bzzzm/commodity-hw/rev1/doc/images/jlcpcb/back.jpg

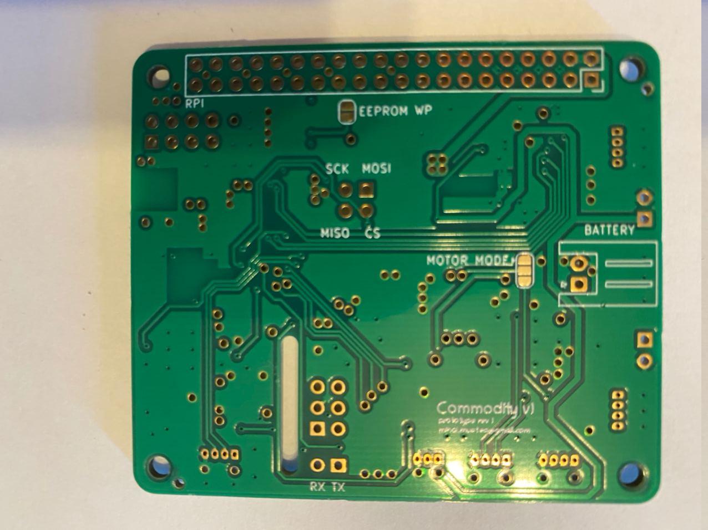
rev1/doc/images/jlcpcb/back.jpg
