bzzzm/commodity-hw/rev1/doc/images/render/top.png

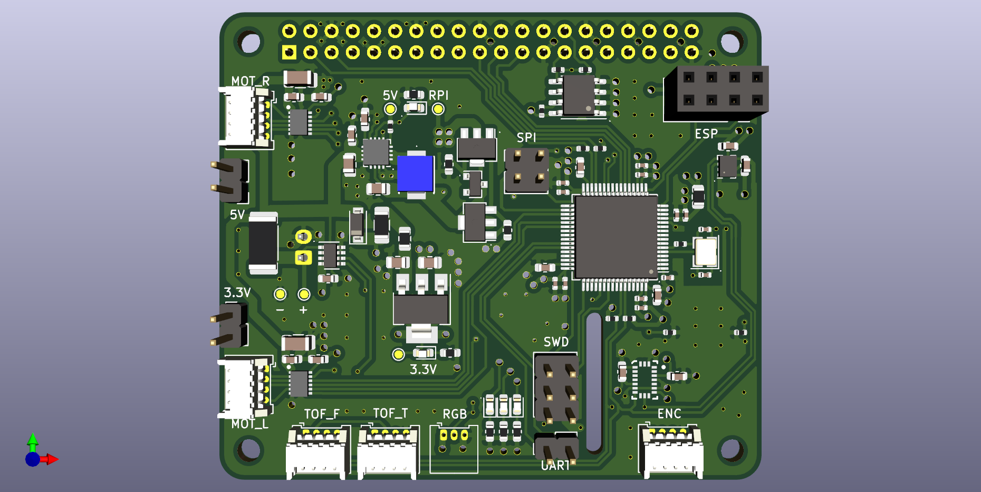
rev1/doc/images/render/top.png
