bzzzm/commodity-hw/README.md

# Commodity - Board

This project requires Kicad 5.1. It should include everything required to order
the board and assemble it (PCBA).
