bzzzm/commodity-hw/rev1/doc/datasheet/README.md

# Datasheet

If you are running linux, you can run `download.sh` to get all the PDFs you need for this board in case you need them offline. All `.pdf` files from `doc` directory are ignored using `gitignore`.
