bzzzm/commodity-hw/rev1/doc/Pins.md

## SWD

Pins are rotated on the board by 180, pin 1 has a square footprint.

  1. +3V3
  2. NRST
  3. GND
  4. SWO
  5. SWCLK
  6. SWDIO
  
## TOF

## MOT_L

## MOT_R

## RGB

## ESP01
