bzzzm/commodity-hw/rev1/doc/images/jlcpcb/front.jpg

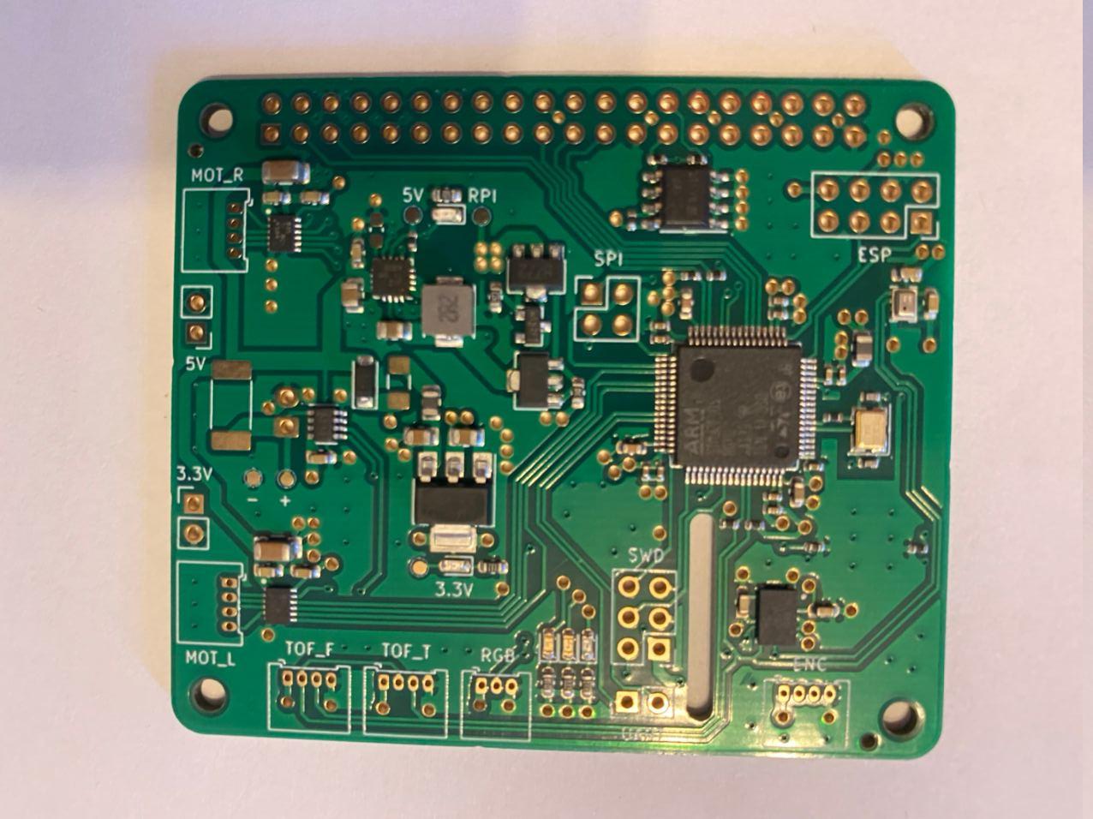
rev1/doc/images/jlcpcb/front.jpg
