bzzzm/commodity-hw/rev1/doc/images/jlcpcb/on_rpi.jpg

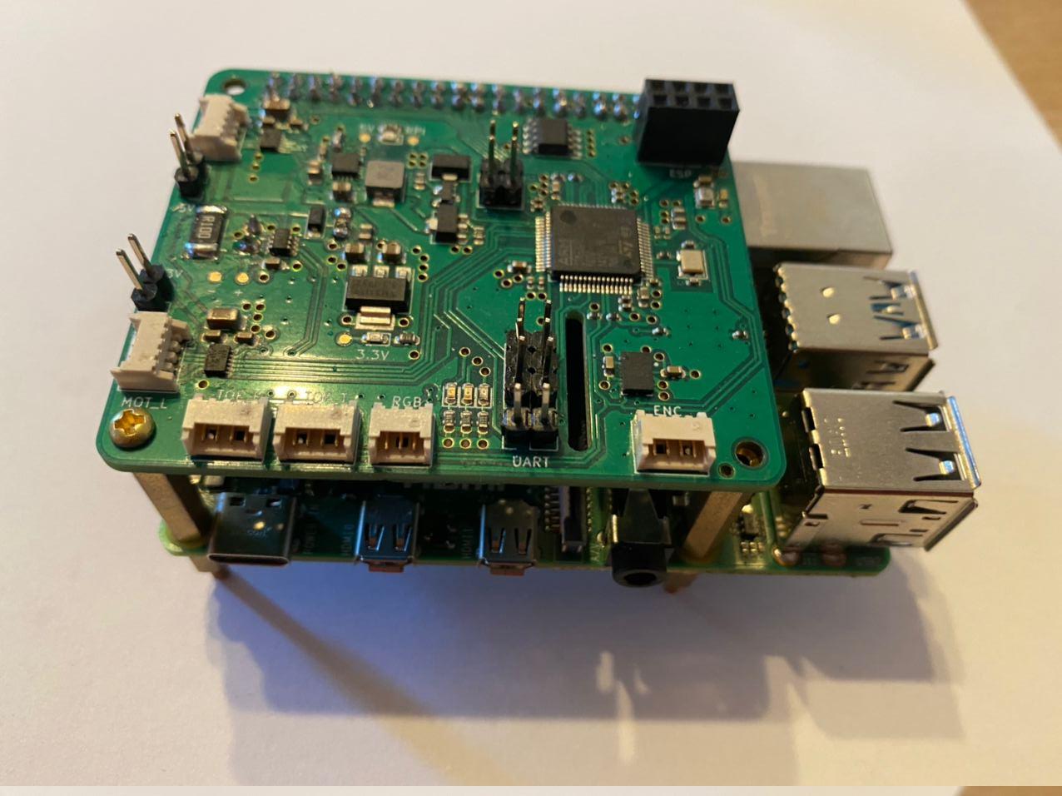
rev1/doc/images/jlcpcb/on_rpi.jpg
