bzzzm/commodity-hw/rev1/doc/images/render/3d-whatever.png

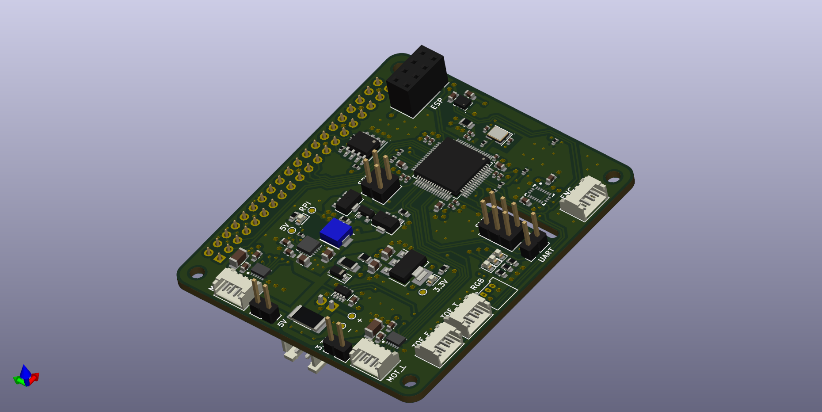
rev1/doc/images/render/3d-whatever.png
