bzzzm/commodity-hw/rev1/doc/images/render/back.png

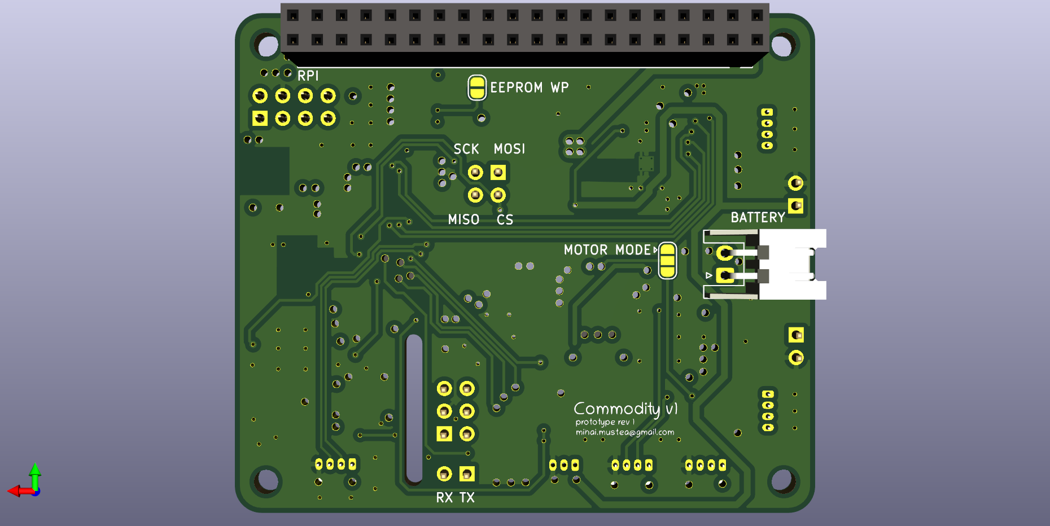
rev1/doc/images/render/back.png
