bzzzm/commodity-hw/rev1/asm/v1-Farnell-bom.csv

Part Number | Quantity | Description
2819768 | 1 | 620pf
2291894 | 1 | 800mA
2779802 | 1 | MOT_L
2779802 | 1 | MOT_R
1516289 | 1 | BAT
2779802 | 1 | ENC Header
9732918 | 1 | RGB Strip Header
2779802 | 1 | TOF_FRONT Header
2779802 | 1 | TOF1_TOP Header
1435952RL | 1 | 0.01
