bzzzm/commodity-hw/rev1/v1.kicad_pcb

## KiCad design rev1/v1.kicad_pcb (2020-09-15)

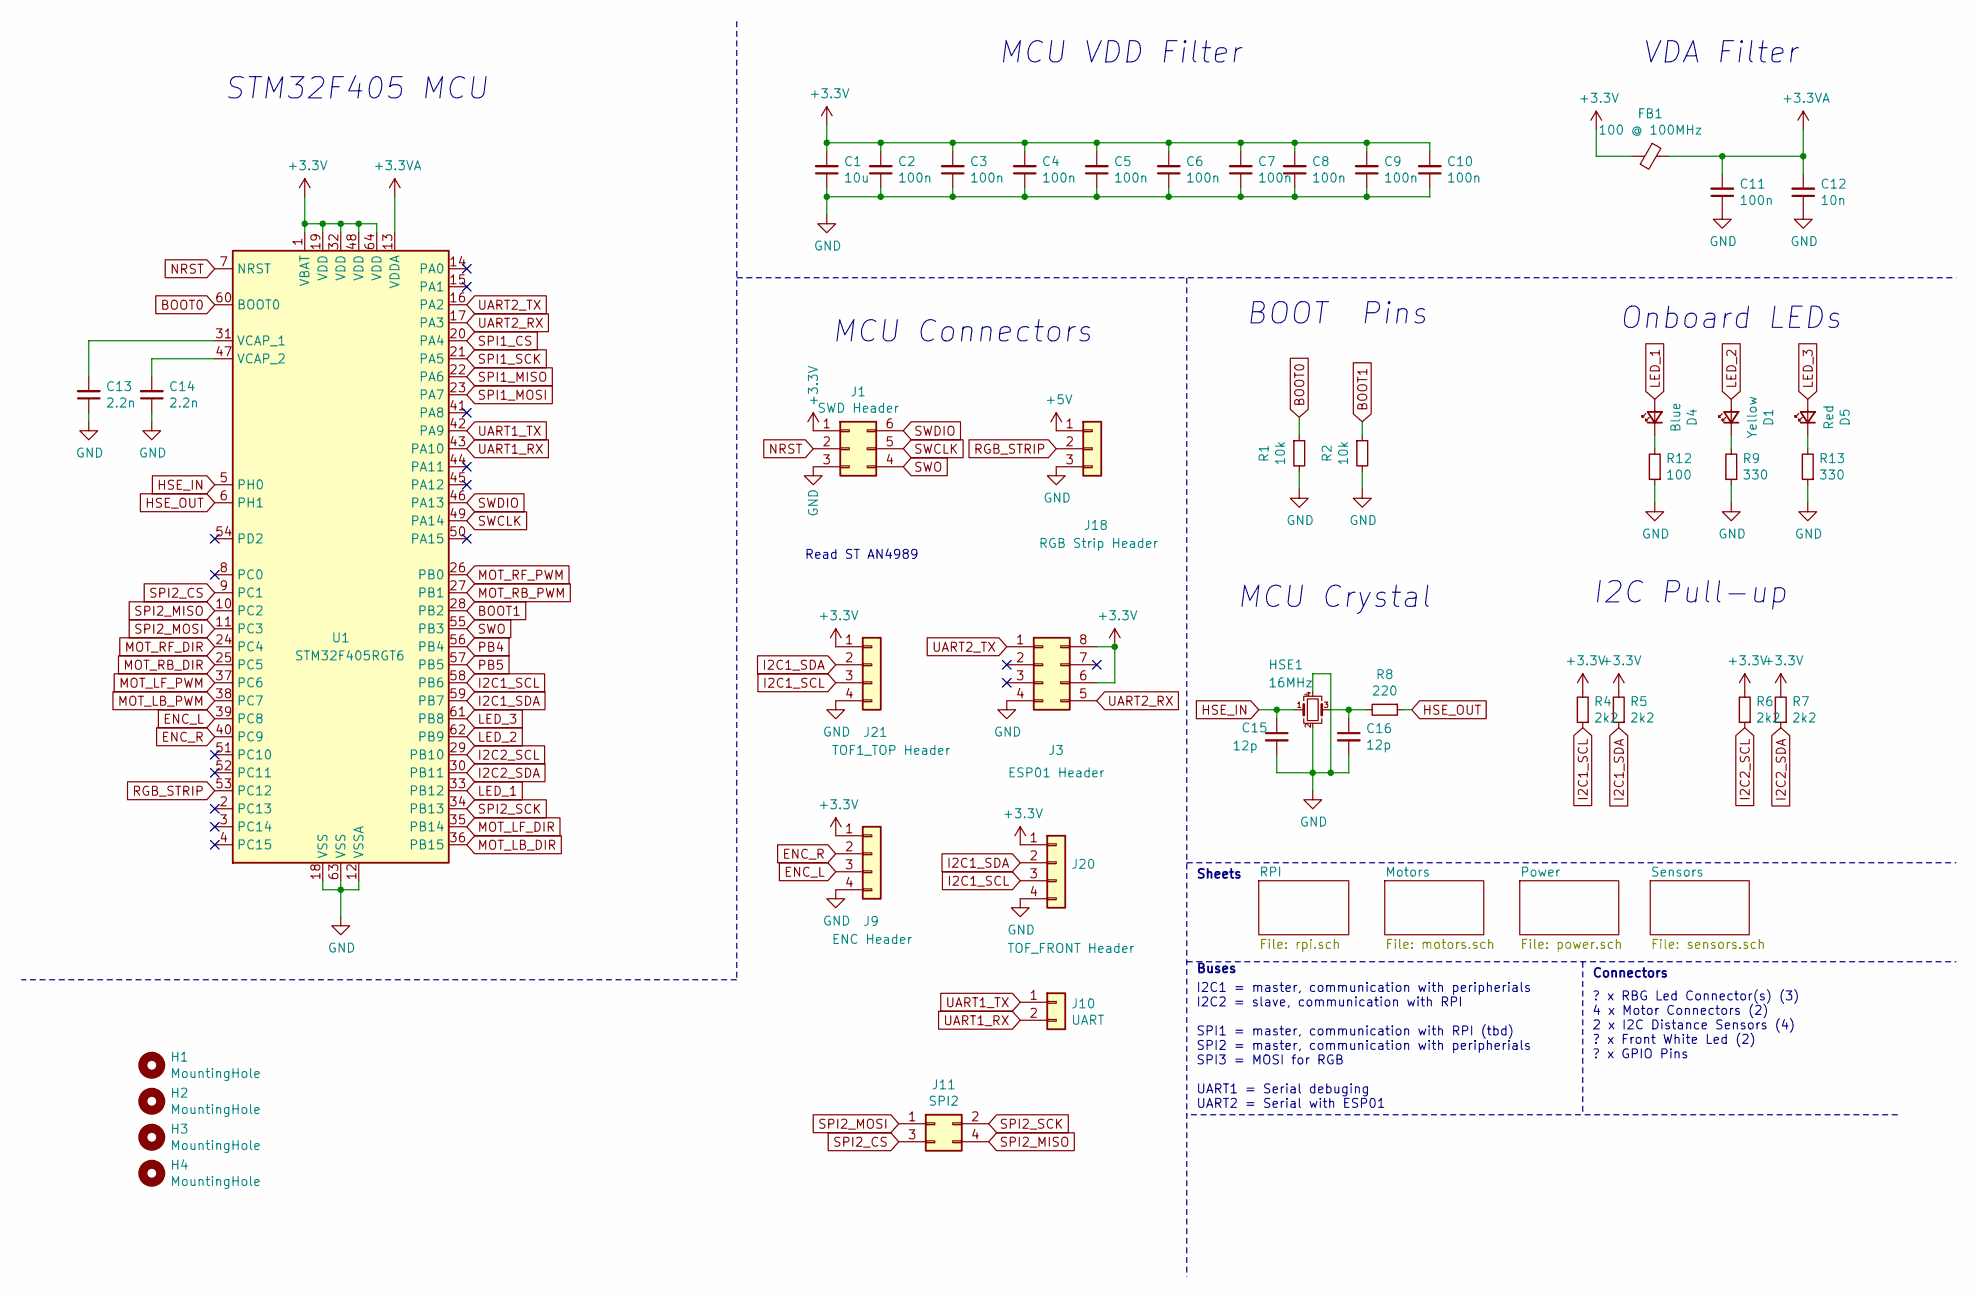
[picture p12: schematic v1.sch, Commodity - Microcontroller]

Parts:
C1: 10u; C_0603_1608Metric; LCSC C19702
C2, C3, C4, C5, C6, C7, C8, C9, C10, C11: 100n; C_0402_1005Metric; LCSC C1525
C12: 10n; C_0402_1005Metric; LCSC C15195
C13, C14: 2.2n; C_0603_1608Metric; LCSC C1604
C15, C16: 12p; C_0402_1005Metric; LCSC C1547
D1: Yellow; LED_0603_1608Metric; LCSC C72038
D4: Blue; LED_0603_1608Metric; LCSC C72041
D5: Red; LED_0603_1608Metric; LCSC C2286
FB1: 100 @ 100MHz; R_0805_2012Metric; LCSC C1015
H1, H2, H3, H4: MountingHole; MountingHole_2.7mm_M2.5
HSE1: 16MHz; Crystal_SMD_3225-4Pin_3.2x2.5mm; LCSC C13738
J1: SWD Header; PinHeader_2x03_P2.54mm_Vertical
J3: ESP01 Header; PinSocket_2x04_P2.54mm_Vertical
J9: ENC Header; Molex_PicoBlade_53048-0410_1x04_P1.25mm_Horizontal; Farnell 2779802
J10: UART; PinHeader_1x02_P2.54mm_Vertical
J11: SPI2; PinHeader_2x02_P2.54mm_Vertical
J18: RGB Strip Header; Molex_PicoBlade_53048-0310_1x03_P1.25mm_Horizontal; Farnell 9732918
J20: TOF_FRONT Header; Molex_PicoBlade_53048-0410_1x04_P1.25mm_Horizontal; Farnell 2779802
J21: TOF1_TOP Header; Molex_PicoBlade_53048-0410_1x04_P1.25mm_Horizontal; Farnell 2779802
R1, R2: 10k; R_0402_1005Metric; LCSC C25744
R4, R5, R6, R7: 2k2; R_0402_1005Metric; LCSC C25879
R8: 220; R_0402_1005Metric; LCSC C25091
R9, R13: 330; R_0603_1608Metric; LCSC C23138
R12: 100; R_0603_1608Metric; LCSC C22775
U1: STM32F405RGT6; LQFP-64_10x10mm_P0.5mm; LCSC C15742

Connections:
+3.3VA: C11.2, C12.2, FB1.1, U1.13 (VDDA)
BOOT0: R1.1, U1.60 (BOOT0)
BOOT1: R2.1, U1.28 (PB2)
ENC_L: J9.3, U1.39 (PC8)
ENC_R: J9.2, U1.40 (PC9)
GND: C1.1, C2.1, C3.1, C4.1, C5.1, C6.1, C7.1, C8.1, C9.1, C10.1, C11.1, C12.1, C13.1, C14.1, C15.2, C16.2, HSE1.2, HSE1.4, J1.3, J3.4, J9.4, J18.3, J20.4, J21.4, R1.2, R2.2, R9.1, R12.1, R13.1, U1.12 (VSSA), U1.18 (VSS), U1.63 (VSS); also elsewhere on the board
HSE_IN: C15.1, HSE1.1, U1.5 (PH0)
HSE_OUT: R8.1, U1.6 (PH1)
I2C1_SCL: J20.3, J21.3, R4.1, U1.58 (PB6); also elsewhere on the board
I2C1_SDA: J20.2, J21.2, R5.1, U1.59 (PB7); also elsewhere on the board
I2C2_SCL: R6.1, U1.29 (PB10); also elsewhere on the board
I2C2_SDA: R7.1, U1.30 (PB11); also elsewhere on the board
LED_1: D4.2 (A), U1.33 (PB12)
LED_2: D1.2 (A), U1.62 (PB9)
LED_3: D5.2 (A), U1.61 (PB8)
MOT_LB_DIR: U1.36 (PB15); also elsewhere on the board
MOT_LB_PWM: U1.38 (PC7); also elsewhere on the board
MOT_LF_DIR: U1.35 (PB14); also elsewhere on the board
MOT_LF_PWM: U1.37 (PC6); also elsewhere on the board
MOT_RB_DIR: U1.25 (PC5); also elsewhere on the board
MOT_RB_PWM: U1.27 (PB1); also elsewhere on the board
MOT_RF_DIR: U1.24 (PC4); also elsewhere on the board
MOT_RF_PWM: U1.26 (PB0); also elsewhere on the board
NRST: J1.2, U1.7 (NRST)
unnamed: C13.2, U1.31 (VCAP_1)
unnamed: C14.2, U1.47 (VCAP_2)
unnamed: C16.1, HSE1.3, R8.2
unnamed: D1.1 (K), R9.2
unnamed: D4.1 (K), R12.2
unnamed: D5.1 (K), R13.2
PB4: U1.56 (PB4)
PB5: U1.57 (PB5)
RGB_STRIP: J18.2, U1.53 (PC12)
SPI1_CS: U1.20 (PA4)
SPI1_MISO: U1.22 (PA6); also elsewhere on the board
SPI1_MOSI: U1.23 (PA7); also elsewhere on the board
SPI1_SCK: U1.21 (PA5); also elsewhere on the board
SPI2_CS: J11.3, U1.9 (PC1)
SPI2_MISO: J11.4, U1.10 (PC2)
SPI2_MOSI: J11.1, U1.11 (PC3)
SPI2_SCK: J11.2, U1.34 (PB13)
SWCLK: J1.5, U1.49 (PA14)
SWDIO: J1.6, U1.46 (PA13)
SWO: J1.4, U1.55 (PB3)
TPS_VOS: J18.1; also elsewhere on the board
UART1_RX: J10.2, U1.43 (PA10)
UART1_TX: J10.1, U1.42 (PA9)
UART2_RX: J3.5, U1.17 (PA3)
UART2_TX: J3.1, U1.16 (PA2)

Notes on the sheet:
I2C1 = master, communication with peripherials I2C2 = slave, communication with RPI SPI1 = master, communication with RPI (tbd) SPI2 = master, communication with peripherials SPI3 = MOSI for RGB UART1 = Serial debuging UART2 = Serial with ESP01
MCU VDD Filter
VDA Filter
BOOT Pins
MCU Crystal
MCU Connectors
I2C Pull-up
? x RBG Led Connector(s) (3) 4 x Motor Connectors (2) 2 x I2C Distance Sensors (4) ? x Front White Led (2) ? x GPIO Pins
Buses
Connectors
Sheets
Read ST AN4989
STM32F405 MCU
Onboard LEDs

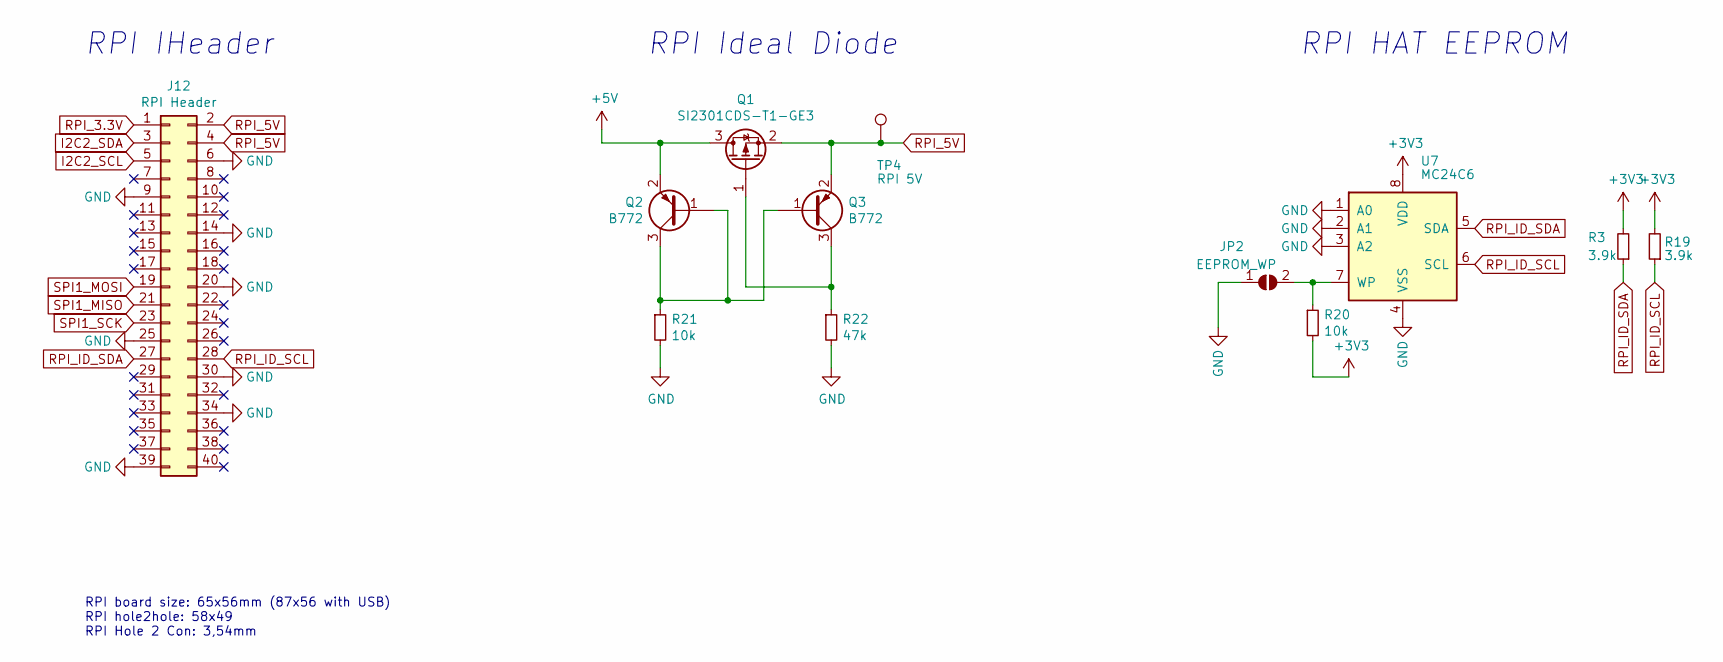
[picture p13: schematic rpi.sch, Commodity - Raspberry PI]

Parts:
J12: RPI Header; PinSocket_2x20_P2.54mm_Vertical
JP2: EEPROM_WP; SolderJumper-2_P1.3mm_Open_RoundedPad1.0x1.5mm
Q1: SI2301CDS-T1-GE3; SOT-23; LCSC C10487
Q2, Q3: B772; SOT-89-3; LCSC C24278
R3, R19: 3.9k; R_0402_1005Metric; LCSC C51721
R20: 10k; R_0402_1005Metric; LCSC C25744
R21: 10k; R_0603_1608Metric; LCSC C25804
R22: 47k; R_0603_1608Metric; LCSC C25819
TP4: RPI 5V; TestPoint_Pad_D1.0mm
U7: MC24C6; SOIC-8_3.9x4.9mm_P1.27mm; LCSC C79988

Connections:
GND: J12.6, J12.9, J12.14, J12.20, J12.25, J12.30, J12.34, J12.39, JP2.1 (A), R21.2, R22.2, U7.1 (A0), U7.2 (A1), U7.3 (A2), U7.4 (VSS); also elsewhere on the board
I2C2_SCL: J12.5; also elsewhere on the board
I2C2_SDA: J12.3; also elsewhere on the board
unnamed: JP2.2 (B), R20.1, U7.7 (WP)
unnamed: Q1.1 (G), Q3.3 (C), R22.1
unnamed: Q2.1 (B), Q2.3 (C), Q3.1 (B), R21.1
RPI_3.3V: J12.1
RPI_5V: J12.2, J12.4, Q1.2 (S), Q3.2 (E), TP4.1
RPI_ID_SCL: J12.28, R19.1, U7.6 (SCL)
RPI_ID_SDA: J12.27, R3.1, U7.5 (SDA)
SPI1_MISO: J12.21; also elsewhere on the board
SPI1_MOSI: J12.19; also elsewhere on the board
SPI1_SCK: J12.23; also elsewhere on the board
TPS_VOS: Q1.3 (D), Q2.2 (E); also elsewhere on the board

Notes on the sheet:
RPI board size: 65x56mm (87x56 with USB) RPI hole2hole: 58x49 RPI Hole 2 Con: 3,54mm
RPI Ideal Diode
RPI IHeader
RPI HAT EEPROM

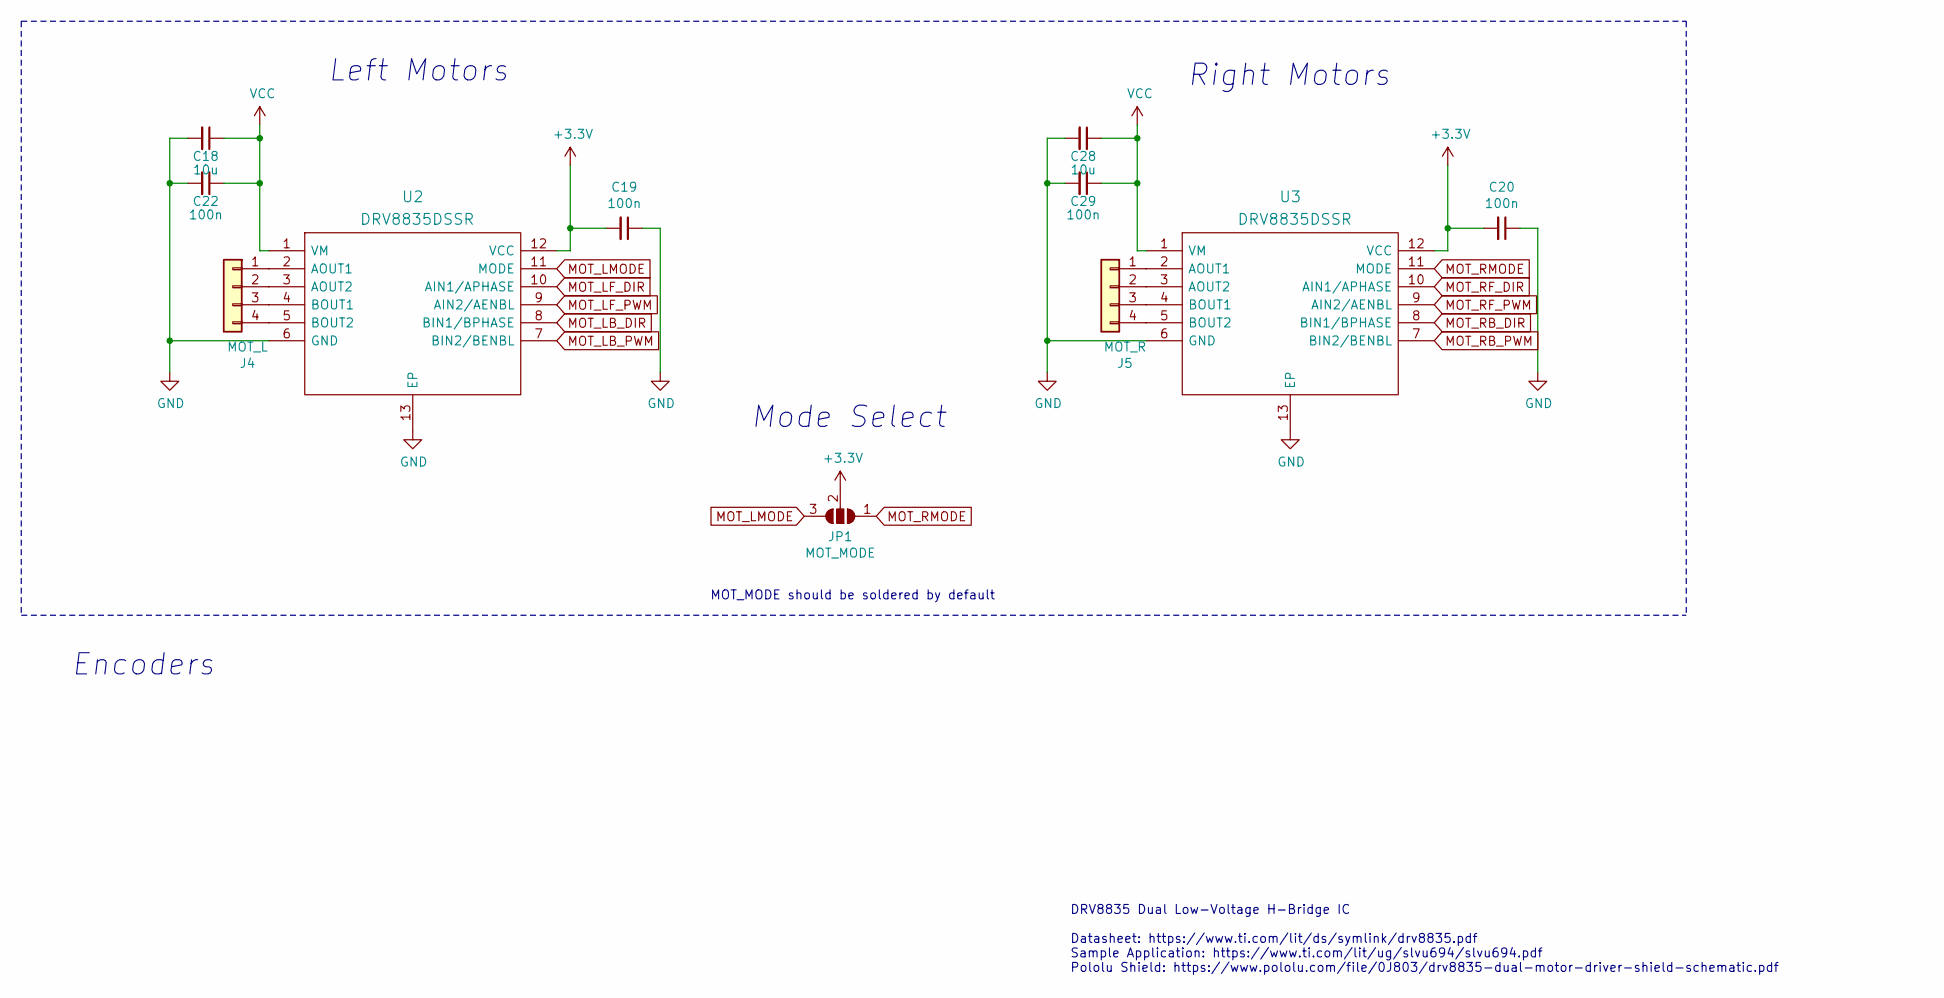
[picture p14: schematic motors.sch, Commodity - Motors]

Parts:
C18, C28: 10u; C_1206_3216Metric; LCSC C13585
C19, C20, C22, C29: 100n; C_0603_1608Metric; LCSC C14663
J4: MOT_L; Molex_PicoBlade_53048-0410_1x04_P1.25mm_Horizontal; Farnell 2779802
J5: MOT_R; Molex_PicoBlade_53048-0410_1x04_P1.25mm_Horizontal; Farnell 2779802
JP1: MOT_MODE; SolderJumper-3_P1.3mm_Open_RoundedPad1.0x1.5mm
U2, U3: DRV8835DSSR; SON50P200X300X80-13N; LCSC C129328

Connections:
GND: C18.2, C19.1, C20.1, C22.2, C28.2, C29.2, U2.6 (GND), U2.13 (EP), U3.6 (GND), U3.13 (EP); also elsewhere on the board
INA_VIN-: C18.1, C22.1, C28.1, C29.1, U2.1 (VM), U3.1 (VM); also elsewhere on the board
MOT_LB_DIR: U2.8 (BIN1/BPHASE); also elsewhere on the board
MOT_LB_PWM: U2.7 (BIN2/BENBL); also elsewhere on the board
MOT_LF_DIR: U2.10 (AIN1/APHASE); also elsewhere on the board
MOT_LF_PWM: U2.9 (AIN2/AENBL); also elsewhere on the board
MOT_LMODE: JP1.3 (B), U2.11 (MODE)
MOT_RB_DIR: U3.8 (BIN1/BPHASE); also elsewhere on the board
MOT_RB_PWM: U3.7 (BIN2/BENBL); also elsewhere on the board
MOT_RF_DIR: U3.10 (AIN1/APHASE); also elsewhere on the board
MOT_RF_PWM: U3.9 (AIN2/AENBL); also elsewhere on the board
MOT_RMODE: JP1.1 (A), U3.11 (MODE)
unnamed: J4.1, U2.2 (AOUT1)
unnamed: J4.2, U2.3 (AOUT2)
unnamed: J4.3, U2.4 (BOUT1)
unnamed: J4.4, U2.5 (BOUT2)
unnamed: J5.1, U3.2 (AOUT1)
unnamed: J5.2, U3.3 (AOUT2)
unnamed: J5.3, U3.4 (BOUT1)
unnamed: J5.4, U3.5 (BOUT2)

Notes on the sheet:
Right Motors
Left Motors
Encoders
DRV8835 Dual Low-Voltage H-Bridge IC Datasheet: https://www.ti.com/lit/ds/symlink/drv8835.pdf Sample Application: https://www.ti.com/lit/ug/slvu694/slvu694.pdf Pololu Shield: https://www.pololu.com/file/0J803/drv8835-dual-motor-driver-shield-schematic.pdf
Mode Select
MOT_MODE should be soldered by default

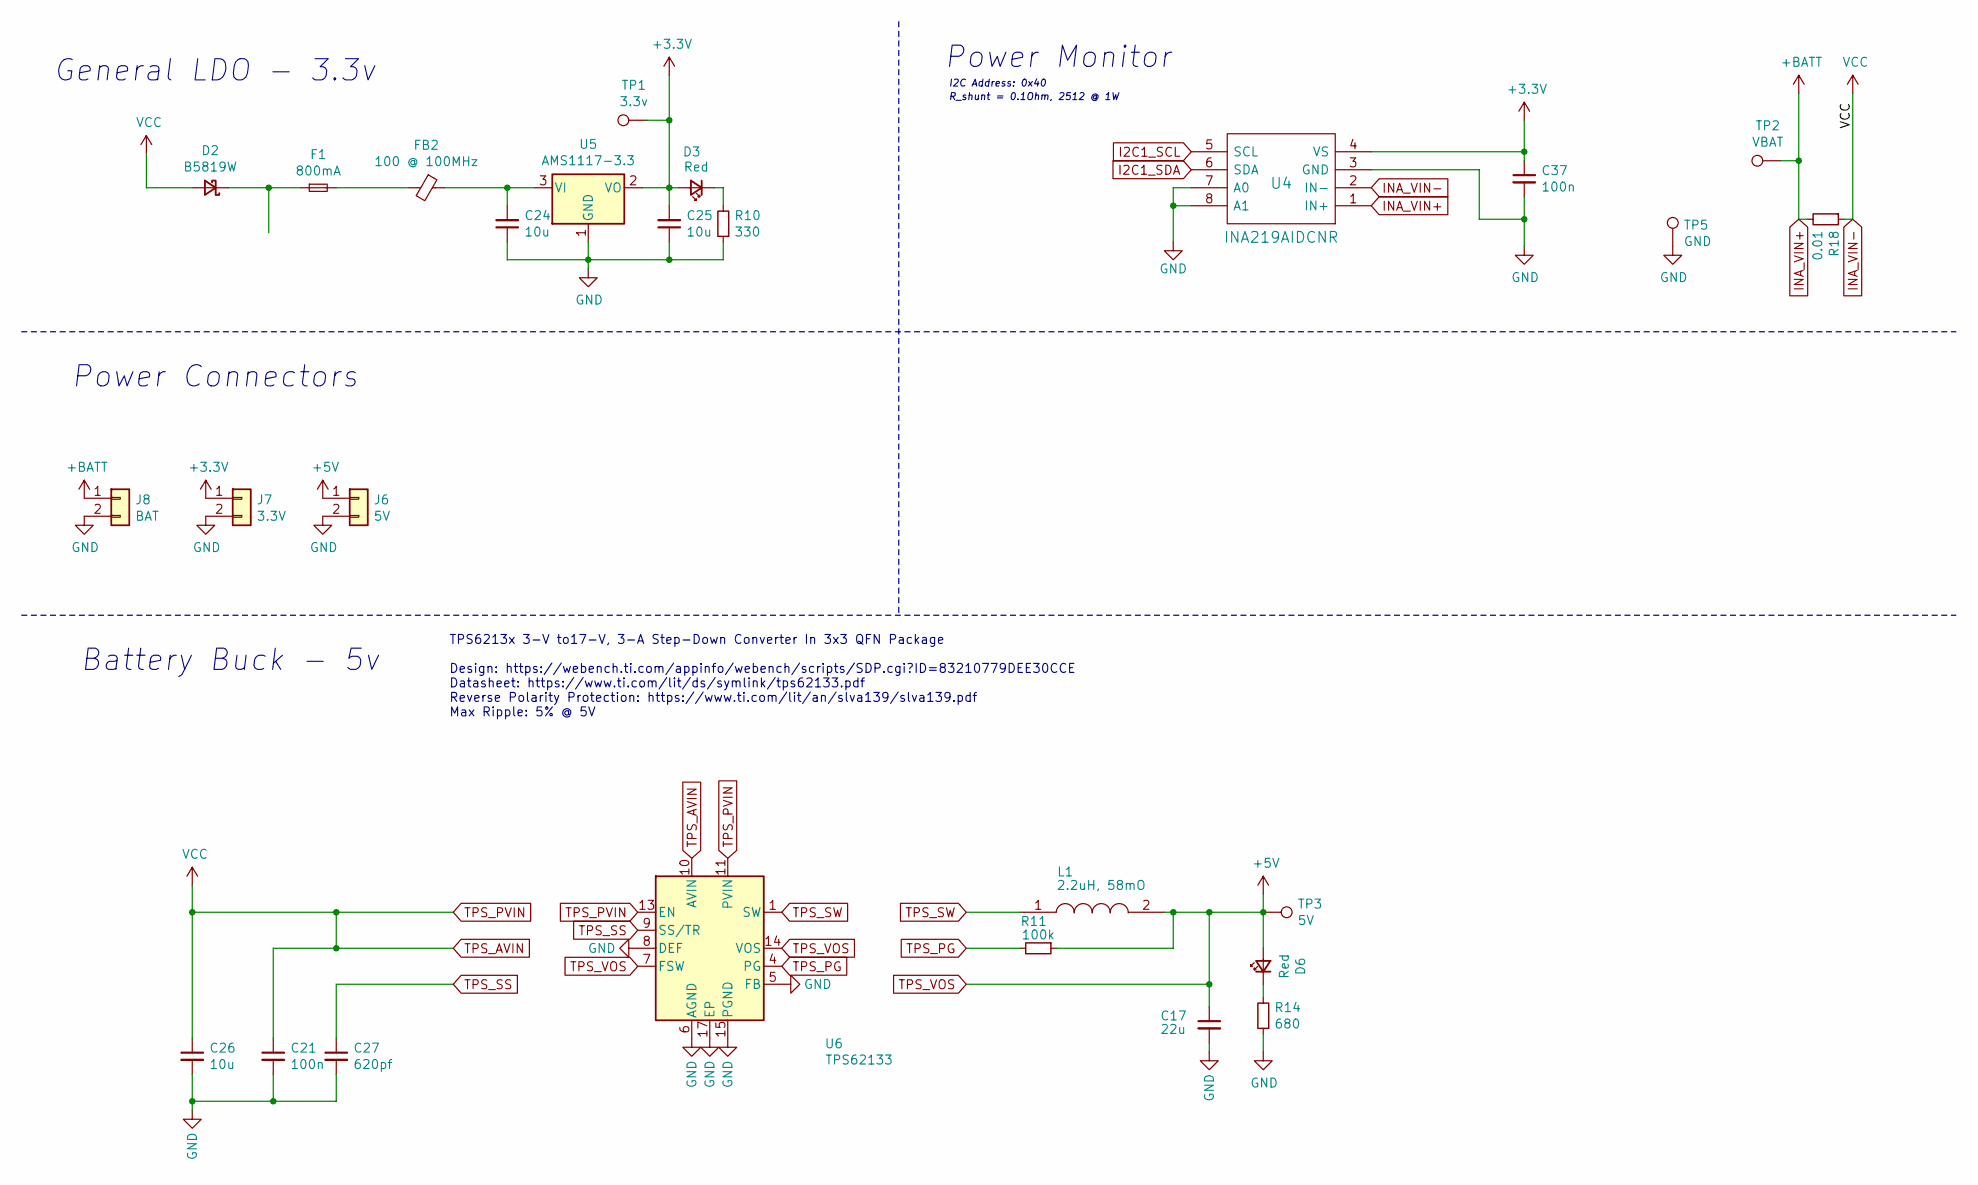
[picture p15: schematic power.sch, Commodity - Power]

Parts:
C17: 22u; C_0805_2012Metric; LCSC C45783
C21, C37: 100n; C_0603_1608Metric; LCSC C14663
C24, C25, C26: 10u; C_0805_2012Metric; LCSC C15850
C27: 620pf; C_0603_1608Metric_Pad1.05x0.95mm_HandSolder; Farnell 2819768
D2: B5819W; D_SOD-123; LCSC C8598
D3, D6: Red; LED_0603_1608Metric; LCSC C2286
F1: 800mA; R_1206_3216Metric_Pad1.42x1.75mm_HandSolder; Farnell 2291894
FB2: 100 @ 100MHz; R_0805_2012Metric; LCSC C1015
J6: 5V; PinHeader_1x02_P2.54mm_Vertical
J7: 3.3V; PinHeader_1x02_P2.54mm_Vertical
J8: BAT; JST_XH_S2B-XH-A_1x02_P2.50mm_Horizontal; Farnell 1516289
L1: 2.2uH, 58mO; INDPM4442X200N; LCSC C408335
R10: 330; R_0603_1608Metric; LCSC C23138
R11: 100k; R_0402_1005Metric; LCSC C25741
R14: 680; R_0603_1608Metric; LCSC C23228
R18: 0.01; R_2512_6332Metric_Pad1.52x3.35mm_HandSolder; Farnell 1435952RL
TP1: 3.3v; TestPoint_Pad_D1.0mm
TP2: VBAT; TestPoint_Pad_D1.0mm
TP3: 5V; TestPoint_Pad_D1.0mm
TP5: GND; TestPoint_Pad_D1.0mm
U4: INA219AIDCNR; SOT-23-8; LCSC C87469
U5: AMS1117-3.3; SOT-223-3_TabPin2; LCSC C6186
U6: TPS62133; VQFN-16-1EP_3x3mm_P0.5mm_EP1.68x1.68mm_ThermalVias; LCSC C73973

Connections:
GND: C17.2, C21.2, C24.1, C25.1, C26.2, C27.2, C37.2, J6.2, J7.2, J8.2, R10.1, R14.1, TP5.1, U4.3 (GND), U4.7 (A0), U4.8 (A1), U5.1 (GND), U6.5 (FB), U6.6 (AGND), U6.8 (DEF), U6.15 (PGND), U6.16 (PGND), U6.17 (EP); also elsewhere on the board
I2C1_SCL: U4.5 (SCL); also elsewhere on the board
I2C1_SDA: U4.6 (SDA); also elsewhere on the board
INA_VIN+: J8.1, R18.2, TP2.1, U4.1 (IN+)
INA_VIN-: C21.1, C26.1, D2.2 (A), R18.1, U4.2 (IN-), U6.10 (AVIN), U6.11 (PVIN), U6.12 (PVIN), U6.13 (EN); also elsewhere on the board
unnamed: C24.2, FB2.1, U5.3 (VI)
unnamed: D2.1 (K), F1.1
unnamed: D3.1 (K), R10.2
unnamed: D6.1 (K), R14.2
unnamed: F1.2, FB2.2
TPS_PG: R11.2, U6.4 (PG)
TPS_SS: C27.1, U6.9 (SS/TR)
TPS_SW: L1.1, U6.1 (SW), U6.2 (SW), U6.3 (SW)
TPS_VOS: C17.1, D6.2 (A), J6.1, L1.2, R11.1, TP3.1, U6.7 (FSW), U6.14 (VOS); also elsewhere on the board

Notes on the sheet:
Battery Buck - 5v
Power Connectors
Power Monitor
TPS6213x 3-V to17-V, 3-A Step-Down Converter In 3x3 QFN Package Design: https://webench.ti.com/appinfo/webench/scripts/SDP.cgi?ID=83210779DEE30CCE Datasheet: https://www.ti.com/lit/ds/symlink/tps62133.pdf Reverse Polarity Protection: https://www.ti.com/lit/an/slva139/slva139.pdf Max Ripple: 5% @ 5V
General LDO - 3.3v
I2C Address: 0x40
R_shunt = 0.1Ohm, 2512 @ 1W

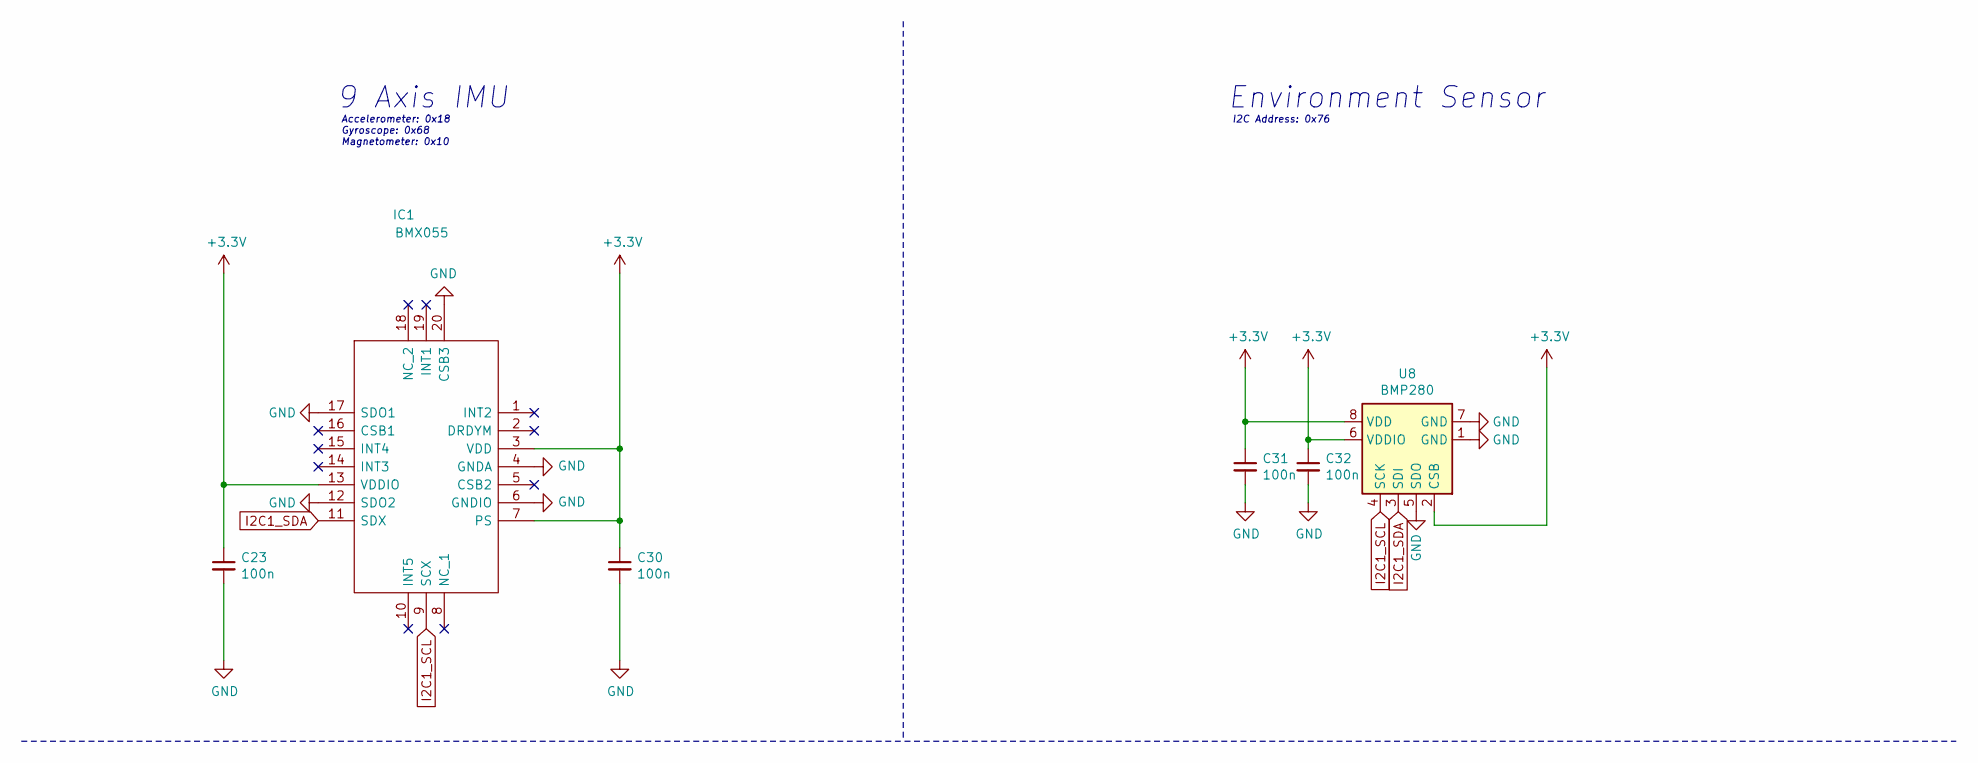
[picture p16: schematic sensors.sch, Commodity - Sensors]

Parts:
C23, C30, C31, C32: 100n; C_0603_1608Metric; LCSC C14663
IC1: BMX055; LGA_PACKAGE_20_PINS; Manufacturer_Part_Number BMX055; Mouser Part Number 262-BMX055
U8: BMP280; Bosch_LGA-8_2x2.5mm_P0.65mm_ClockwisePinNumbering; LCSC C83291

Connections:
GND: C23.2, C30.2, C31.2, C32.2, IC1.4 (GNDA), IC1.6 (GNDIO), IC1.12 (SDO2), IC1.17 (SDO1), IC1.20 (CSB3), U8.1 (GND), U8.5 (SDO), U8.7 (GND); also elsewhere on the board
I2C1_SCL: IC1.9 (SCX), U8.4 (SCK); also elsewhere on the board
I2C1_SDA: IC1.11 (SDX), U8.3 (SDI); also elsewhere on the board

Notes on the sheet:
Accelerometer: 0x18 Gyroscope: 0x68 Magnetometer: 0x10
9 Axis IMU
I2C Address: 0x76
Environment Sensor

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
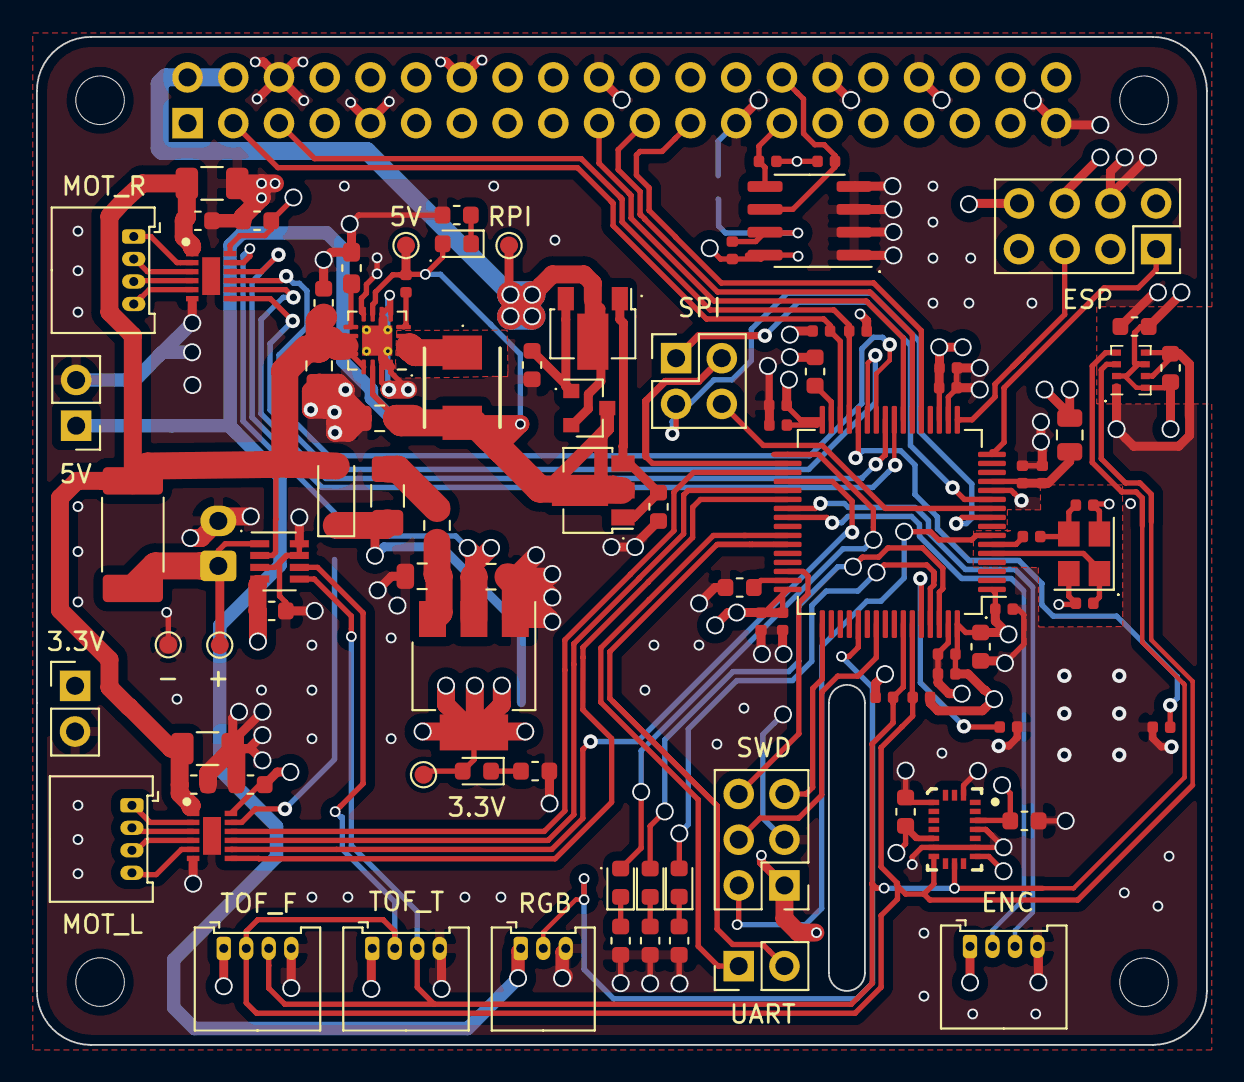
[picture p17: board v1.kicad_pcb from above]

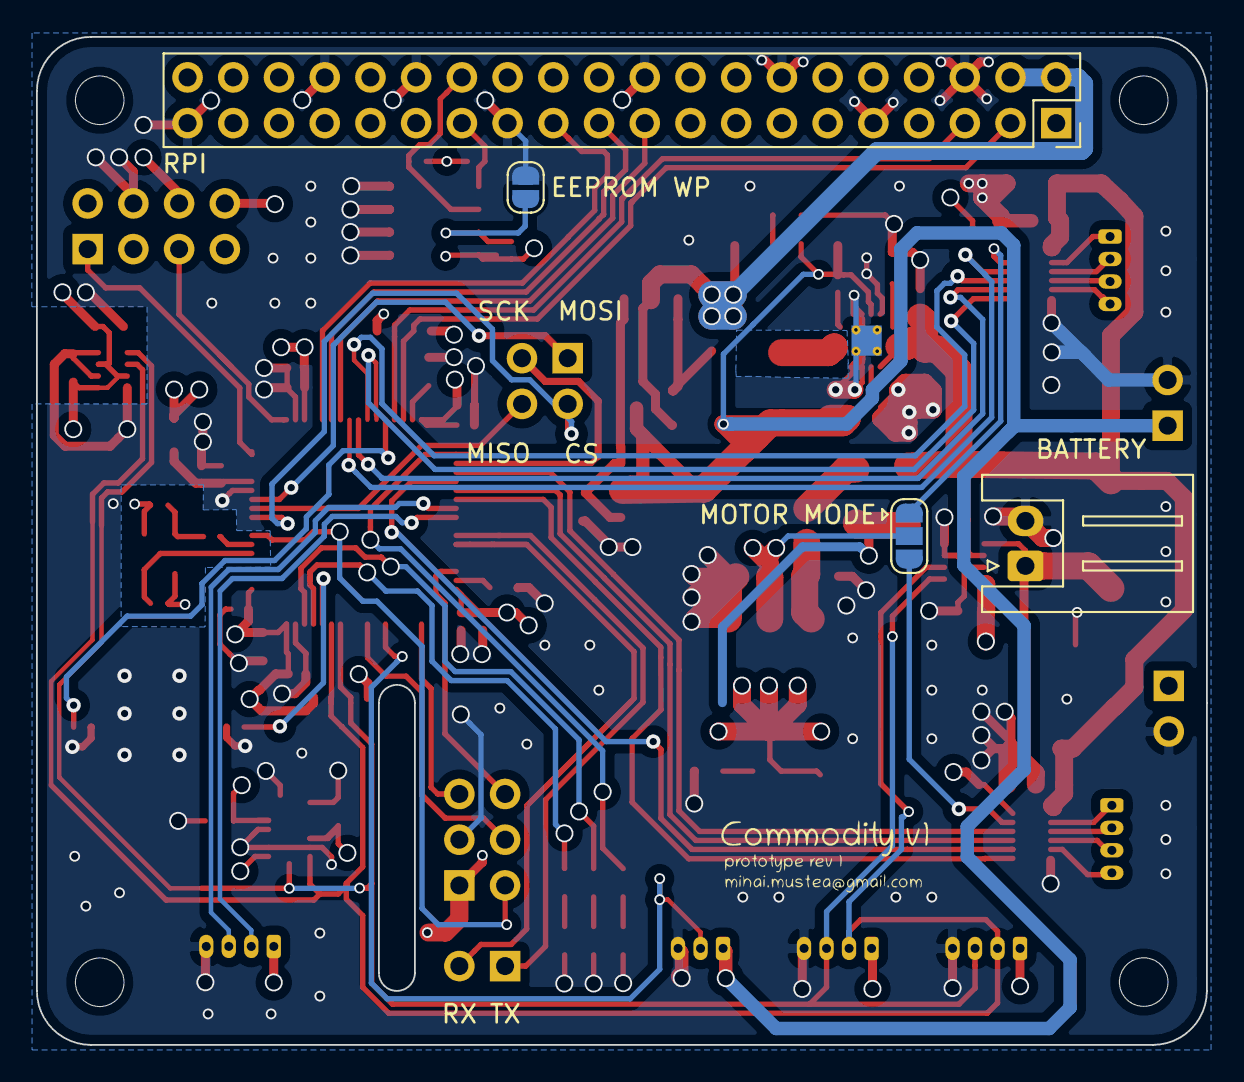
[picture p18: board v1.kicad_pcb from below]

Board: 4 copper layers, 65.0 x 56.0 mm, 100 parts (4 on the bottom side), 73 nets.
