bzzzm/commodity-hw/(commit log)

2020-09-15 initial github release
    [motors.sch, power.sch, rpi.sch, sensors.sch, v1-Empty-bom.csv, v1-Farnell-bom.csv, v1-JLCPCB-bom.csv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]
2020-09-15 added pdf schematic
